tuomasnylund/function-gen/documentation/gui_example.png

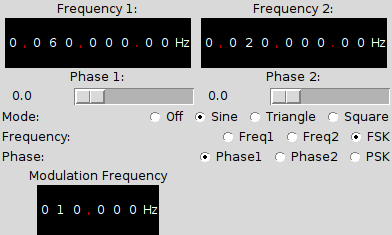
documentation/gui_example.png
