tuomasnylund/function-gen/pcb/function-gen.sch

## KiCad design pcb/function-gen.sch (2012-08-10)

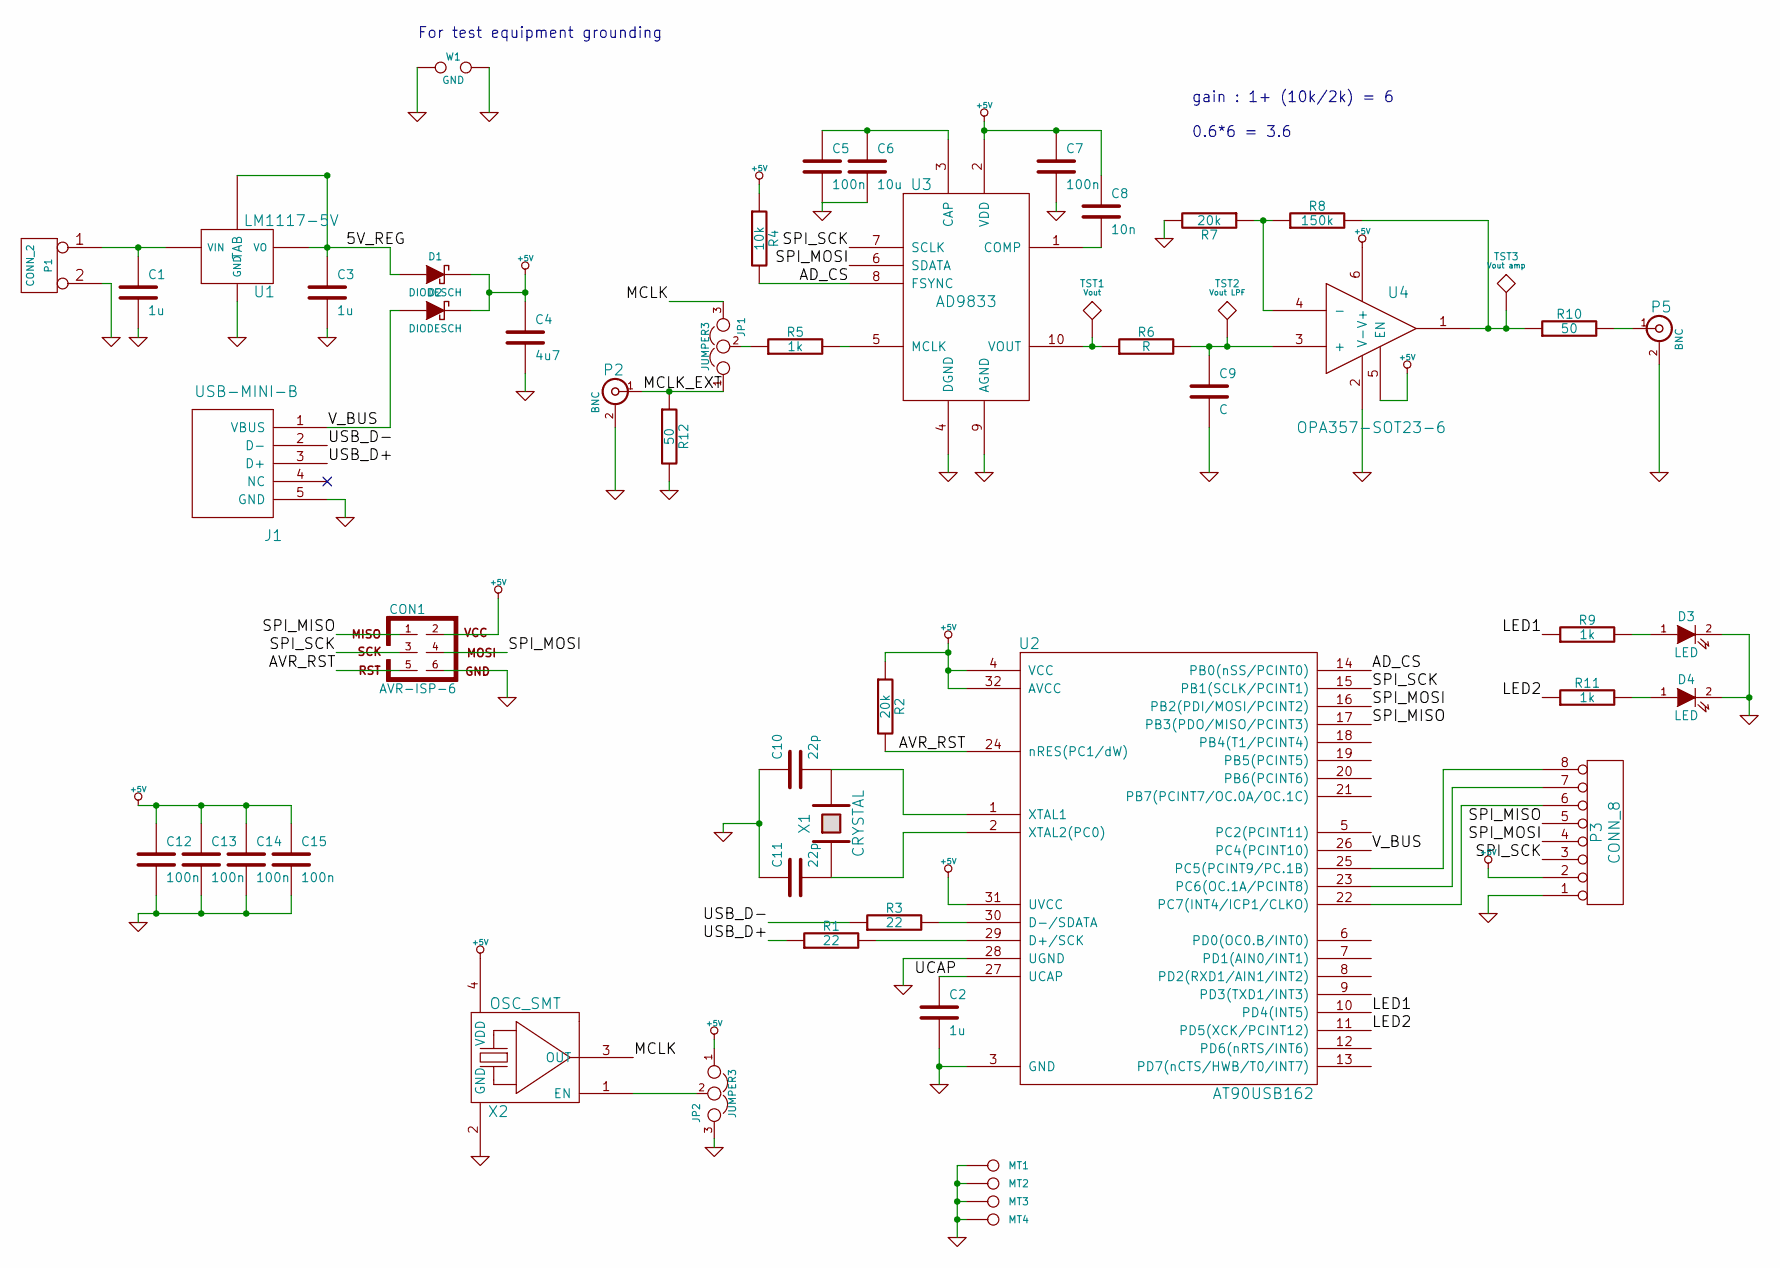
[picture p4: schematic function-gen.sch]

Parts:
C1, C2, C3: 1u
C4: 4u7
C5, C7, C12, C13, C14, C15: 100n
C6: 10u
C8: 10n
C9: C
C10, C11: 22p
CON1: AVR-ISP-6
D1, D2: DIODESCH
D3, D4: LED
J1: USB-MINI-B
JP1, JP2: JUMPER3
MT1, MT2, MT3, MT4: CONN_1
P1: CONN_2
P2, P5: BNC
P3: CONN_8
R1, R3: 22
R2, R7: 20k
R4: 10k
R5, R9, R11: 1k
R6: R
R8: 150k
R10, R12: 50
TST1: Vout
TST2: Vout LPF
TST3: Vout amp
U1: LM1117-5V
U2: AT90USB162
U3: AD9833
U4: OPA357-SOT23-6
W1: GND
X1: CRYSTAL
X2: OSC_SMT

Connections:
5V_REG: C3.1, D1.1 (A), U1.2 (VO), U1.4 (TAB)
+5V: C4.1, C7.1, C8.1, C12.1, C13.1, C14.1, C15.1, CON1.2, D1.2 (K), D2.2 (K), JP2.1, P3.2, R2.1, R4.1, U2.4 (VCC), U2.31 (UVCC), U2.32 (AVCC), U3.2 (VDD), U4.5 (EN), U4.6 (V+), X2.4 (VDD)
AD_CS: R4.2, U2.14 (PB0(nSS/PCINT0)), U3.8 (FSYNC)
AVR_RST: CON1.5, R2.2, U2.24 (nRES(PC1/dW))
GND: C1.2, C2.2, C3.2, C4.2, C5.2, C6.2, C7.2, C9.2, C10.1, C11.1, C12.2, C13.2, C14.2, C15.2, CON1.6, D3.2 (K), D4.2 (K), J1.5 (GND), JP2.3, MT1.1, MT2.1, MT3.1, MT4.1, P1.2 (PM), P2.2 (Ext), P3.1, P5.2 (Ext), R7.2, R12.2, U1.1 (GND), U2.3 (GND), U2.28 (UGND), U3.4 (DGND), U3.9 (AGND), U4.2 (V-), W1.1, W1.2, X2.2 (GND)
LED1: R9.1, U2.10 (PD4(INT5))
LED2: R11.1, U2.11 (PD5(XCK/PCINT12))
MCLK: JP1.3, X2.3 (OUT)
MCLK_EXT: JP1.1, P2.1 (In), R12.1
unnamed: C1.1, P1.1, U1.3 (VIN)
unnamed: C5.1, C6.1, U3.3 (CAP)
unnamed: C8.2, U3.1 (COMP)
unnamed: C9.1, R6.2, TST2.1, U4.3 (+)
unnamed: C10.2, U2.1 (XTAL1), X1.2
unnamed: C11.2, U2.2 (XTAL2(PC0)), X1.1
unnamed: D3.1 (A), R9.2
unnamed: D4.1 (A), R11.2
unnamed: JP1.2, R5.1
unnamed: JP2.2, X2.1 (EN)
unnamed: P3.6, U2.22 (PC7(INT4/ICP1/CLKO))
unnamed: P3.7, U2.23 (PC6(OC.1A/PCINT8))
unnamed: P3.8, U2.25 (PC5(PCINT9/PC.1B))
unnamed: P5.1 (In), R10.2
unnamed: R1.2, U2.29 (D+/SCK)
unnamed: R3.2, U2.30 (D-/SDATA)
unnamed: R5.2, U3.5 (MCLK)
unnamed: R6.1, TST1.1, U3.10 (VOUT)
unnamed: R7.1, R8.1, U4.4 (-)
unnamed: R8.2, R10.1, TST3.1, U4.1
SPI_MISO: CON1.1, P3.5, U2.17 (PB3(PDO/MISO/PCINT3))
SPI_MOSI: CON1.4, P3.4, U2.16 (PB2(PDI/MOSI/PCINT2)), U3.6 (SDATA)
SPI_SCK: CON1.3, P3.3, U2.15 (PB1(SCLK/PCINT1)), U3.7 (SCLK)
UCAP: C2.1, U2.27 (UCAP)
USB_D+: J1.3 (D+), R1.1
USB_D-: J1.2 (D-), R3.1
V_BUS: D2.1 (A), J1.1 (VBUS), U2.26 (PC4(PCINT10))

Notes on the sheet:
gain : 1+ (10k/2k) = 6 0.6*6 = 3.6
For test equipment grounding
