tuomasnylund/function-gen/(commit log)

2012-06-20 changed opamp feedback resistors
    [function-gen.sch]
2012-06-21 implemented power on-ff starts up turned off
2012-07-14 fixed overflow with calculating modulation freq
    [ad9833.h]
2012-08-10 PCB change, AVR-VBUS connected to +5V, not to USB
    [function-gen.brd, function-gen.sch]
